minhkhoinguyen206-netizen/F450-GPS-Quadcopter1/images/07-arms-populated.jpg

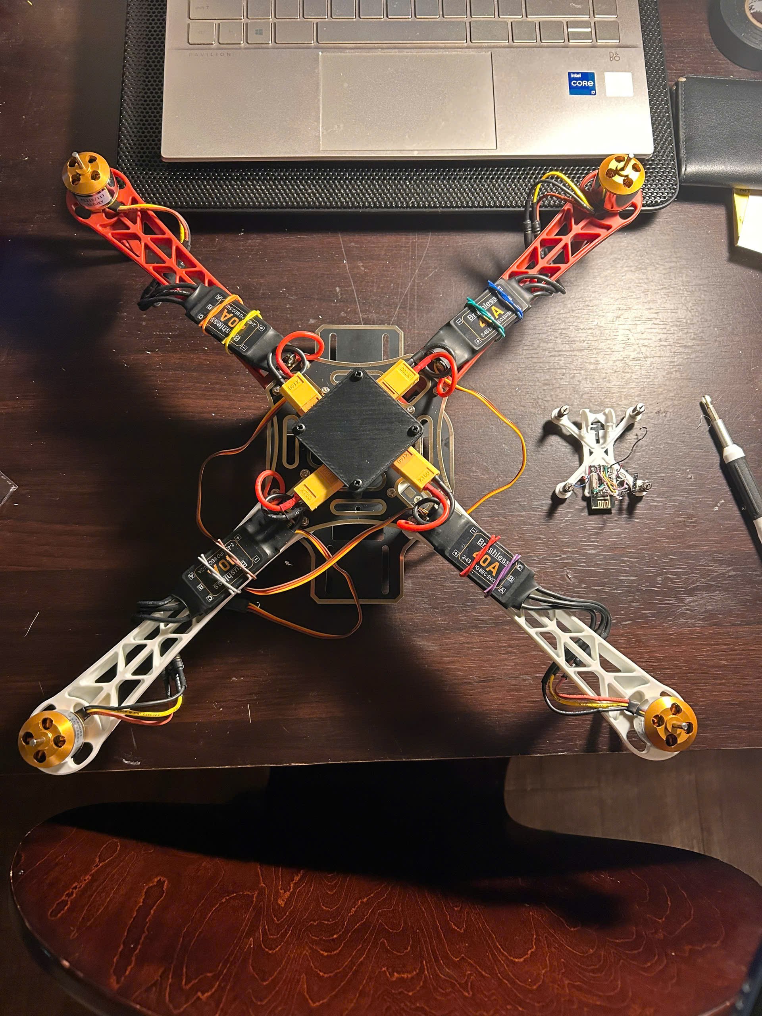
images/07-arms-populated.jpg
