minhkhoinguyen206-netizen/F450-GPS-Quadcopter1/images/11-xt60-to-pdb.jpg

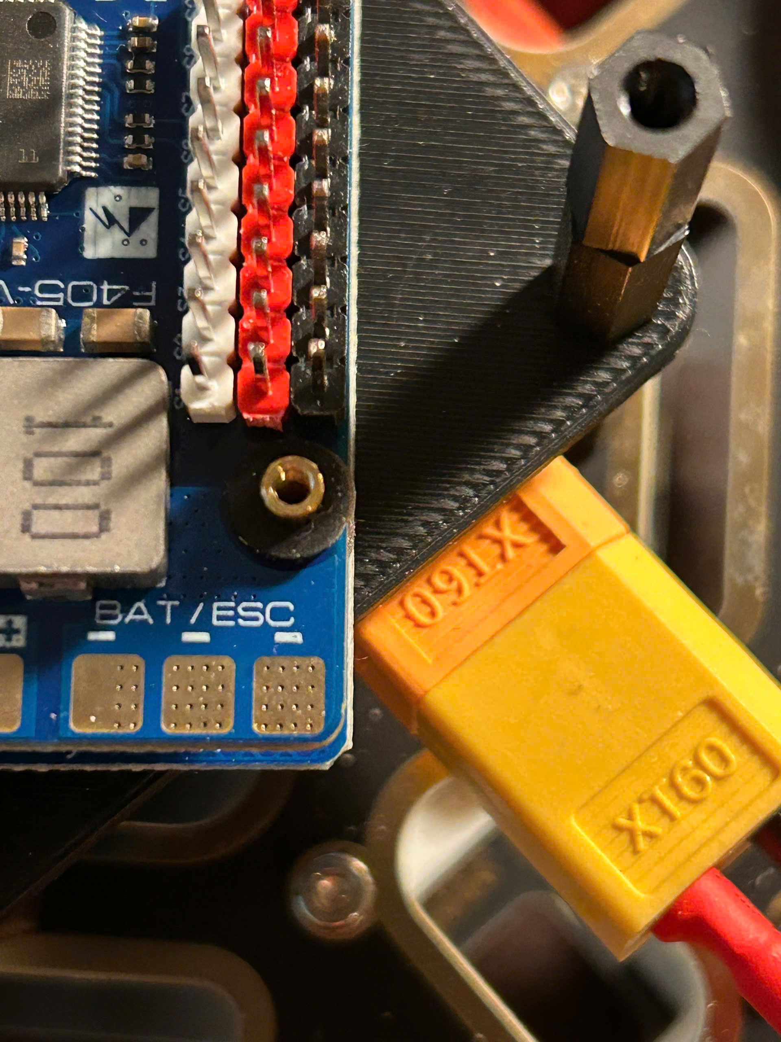
images/11-xt60-to-pdb.jpg
