minhkhoinguyen206-netizen/F450-GPS-Quadcopter1/images/16-inav-bench-session.jpg

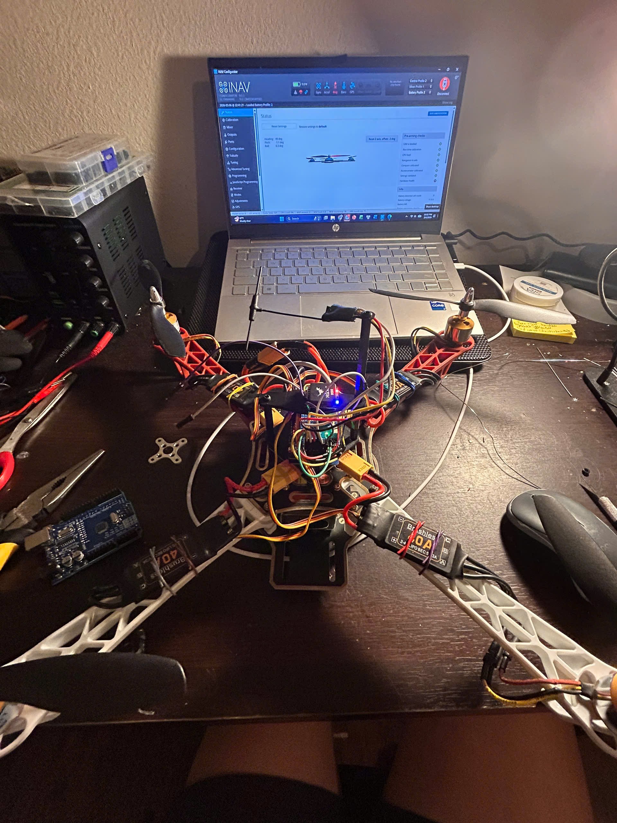
images/16-inav-bench-session.jpg
