minhkhoinguyen206-netizen/F450-GPS-Quadcopter1/images/22-prop-adapter-hardware.jpg

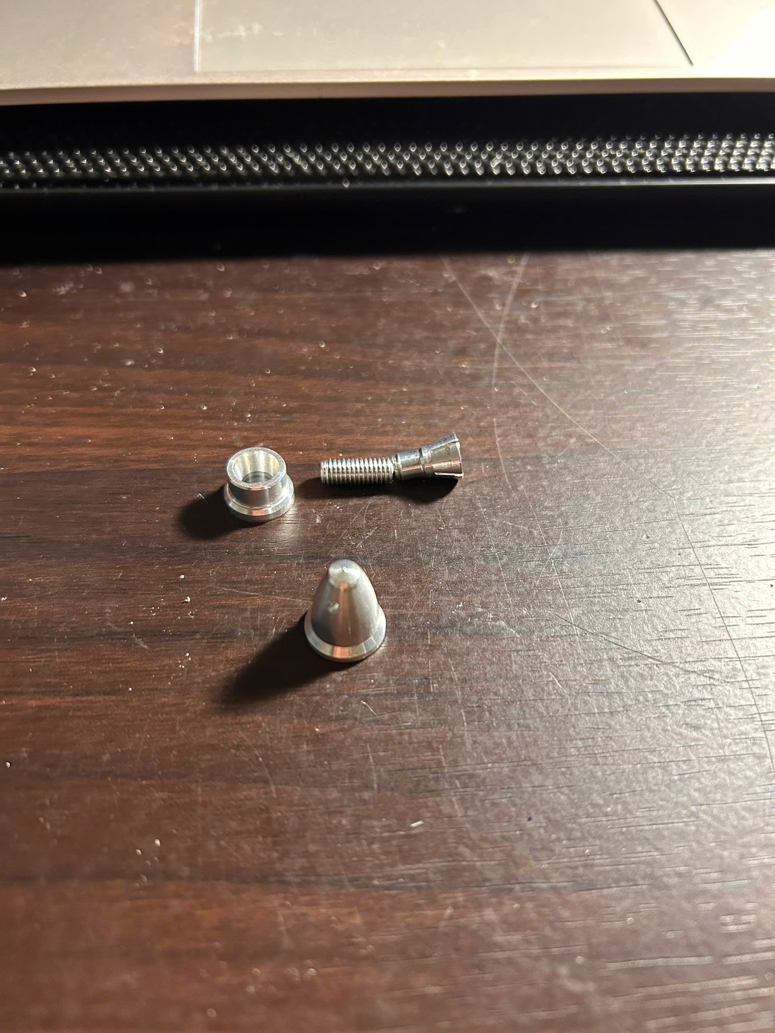
images/22-prop-adapter-hardware.jpg
