minhkhoinguyen206-netizen/F450-GPS-Quadcopter1/images/27-v2-detail.jpg

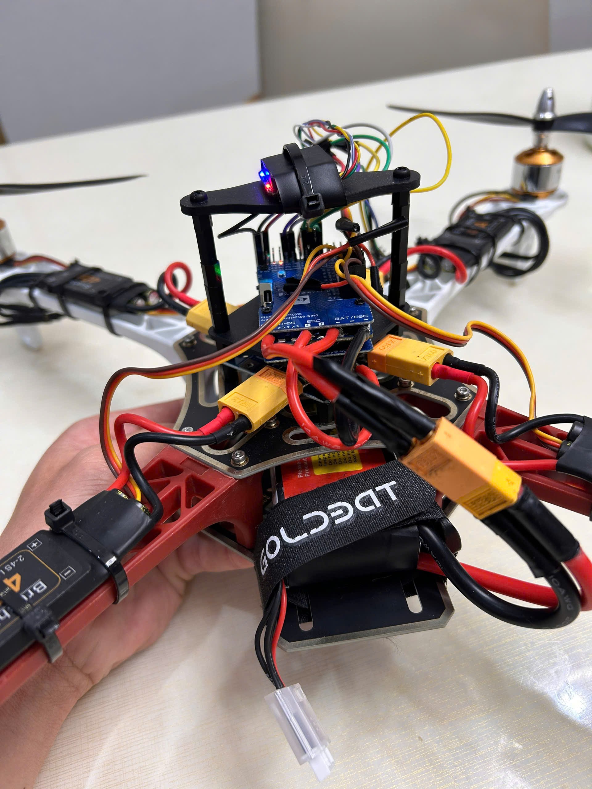
images/27-v2-detail.jpg
