minhkhoinguyen206-netizen/F450-GPS-Quadcopter1/images/29-flight-over-court.jpg

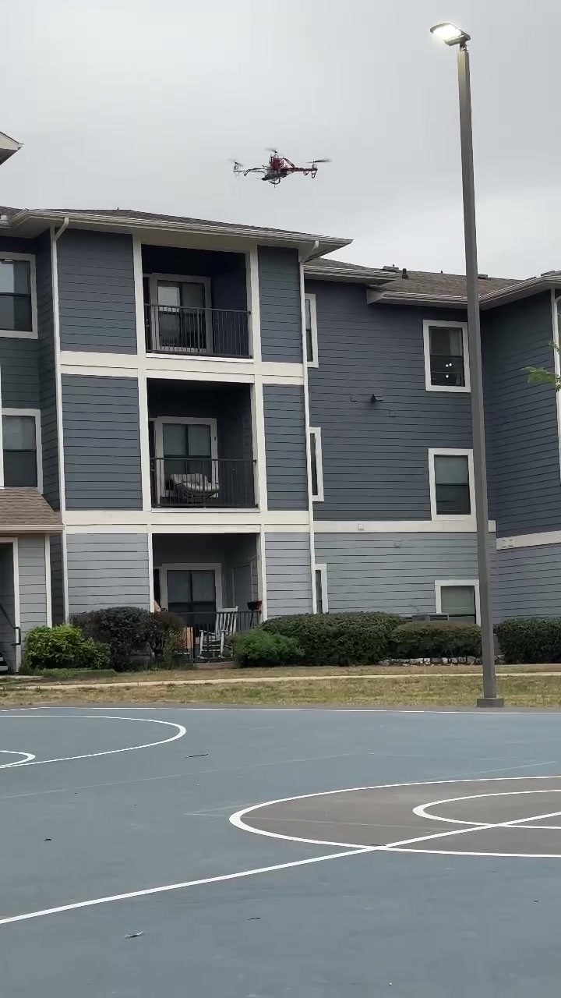
images/29-flight-over-court.jpg
