minhkhoinguyen206-netizen/F450-GPS-Quadcopter1/images/33-flight-altitude-hold.jpg

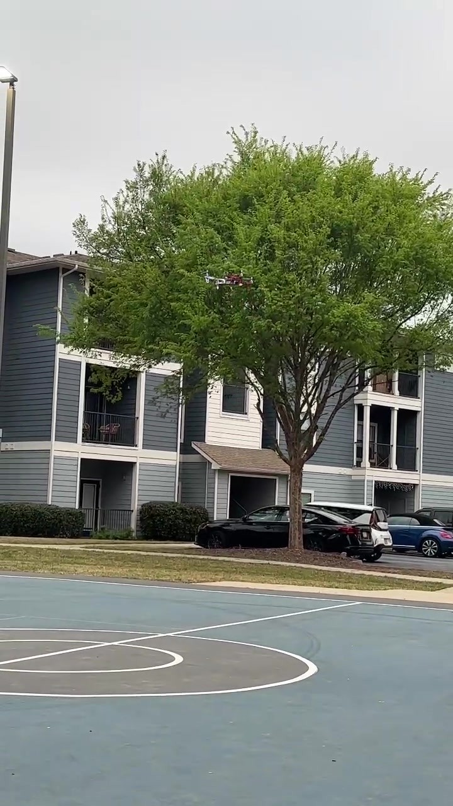
images/33-flight-altitude-hold.jpg
