minhkhoinguyen206-netizen/F450-GPS-Quadcopter1/images/23-v1-assembled.jpg

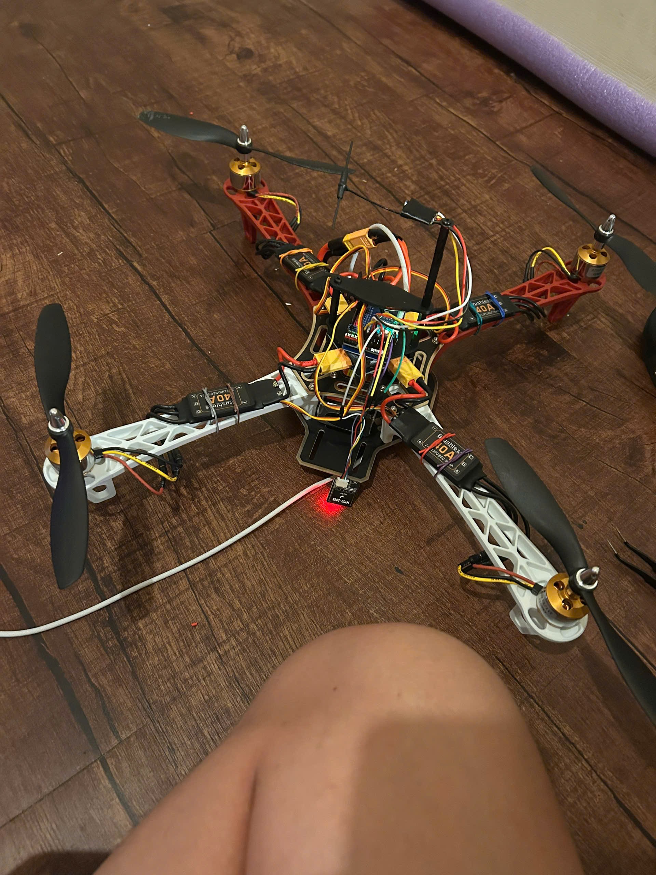
images/23-v1-assembled.jpg
