minhkhoinguyen206-netizen/F450-GPS-Quadcopter1/inav_config/cli_dump.txt

# Placeholder.
#
# Regenerate with `dump all` in the INAV CLI and paste the console output here.
# See notes.md for the open item on motor_pwm_protocol.
